richardyjtian/Robot-School-Project/P1PR1_Circuit_Snip.JPG

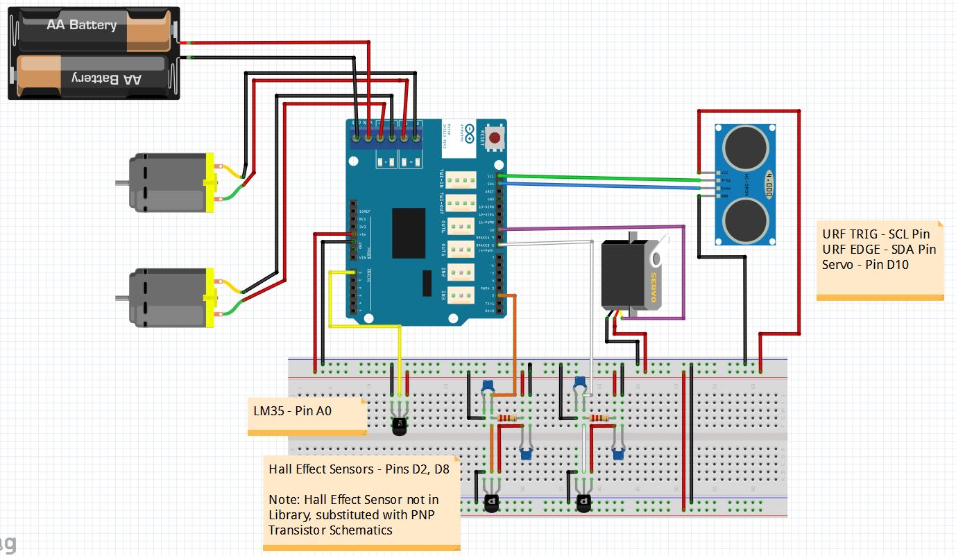
P1PR1_Circuit_Snip.JPG
