richardyjtian/Robot-School-Project/README.md

# Autonomous Robot
A copy of the autonomous robot project created by Richard Tian, Sammy Brache, Zhihang Zhang, Amir Tootooni, Robin Reyes, and Johnny Ma
Core files are located in the "Main files" folder
