richardyjtian/Robot-School-Project/(list of files, drawings)

Other design files:
Main files/Fritzing.fzz
P1 _PR1_Circuit.fzz
