richardyjtian/Robot-School-Project/(commit log)

2018-08-13 added project
    [Motor Graphs.xlsx, P1 _PR1_Circuit.fzz, Project 1 Fritzing.fzz, project1.fzz, project1_updated.fzz]
2018-12-13 Cleaned up
    [Fritzing.fzz, Project 1 Fritzing.fzz, project1.fzz]
